team-phantom-community/Phox_Hardware/README.md

# Phoxハードウェア

## 概要
Phoxのハードウェアは完全自作のマイコンボードを中核として様々な小型デバイスを用いている

特にここでは
- 自作ボード回路図
- ハードウェアコンポーネント
- ハードウェア用C++コード

について述べていく

## 必須環境
- Kicad Version 7
- Arduino IDE 2
- ソルダーペースト（ペースト半田）
  - 必須ではないが推奨される
- 半田ごて
- ホットプレート or 温度制限機能付きコンロとフライパン
- 3Dプリンター
- 根気<-最重要
