team-phantom-community/Phox_Hardware/3Ddata/README.md

# 3Dモデルデータ

## 概要
- Phoxの筐体は全て3Dプリントで作成されている
- 上部のLEDについては少し下に向けることで郵便受け全体に明かりを当てられるようにしてある
- カメラの部分についてはスリットを入れることで、過度にカメラを押し付けない仕組みとしてある
- なお、データについてはstlデータのみ載せておく
