team-phantom-community/Phox_Hardware/Phox-code/README.md

# Phox専用C++ code

## 概要
- このコードの役割は
  - 磁気スイッチのオンオフを読む
  - カメラで画像を撮影する
  - バッテリーの電圧を計る
  - Base64変換した画像、測距センサのデータ、バッテリー電圧をJsonデータとしてAWSのAPIGateWayに送る
- 作成したメインボードに[コード](phox_code)を書き込み磁気スイッチに磁石を近づけるとAWS S3に画像が保存される

## AWSのAPI設定
- ここではAWS lambda上で作成したphox image uploaderにAPI Gatewayを関連付ける

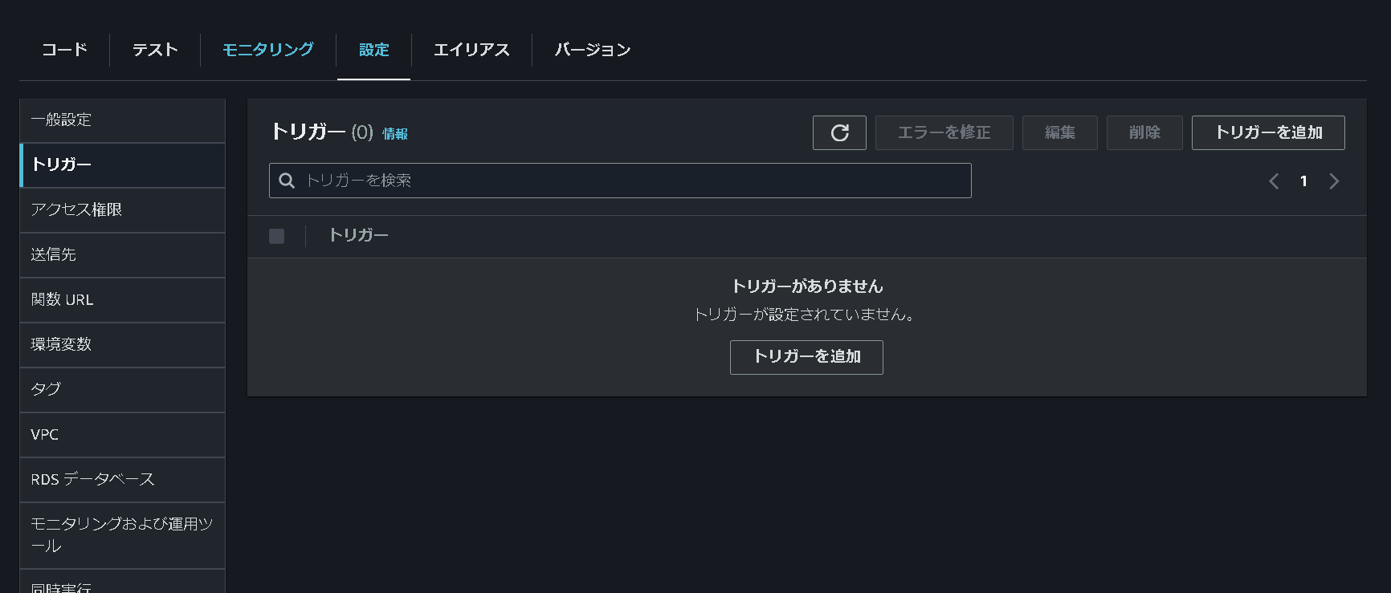
[picture p2: Phox-code/image/set-trigger.PNG]
トリガー設定

- 作成したlambdaの「設定」->「トリガー」に入り、「トリガーを追加」をクリックする

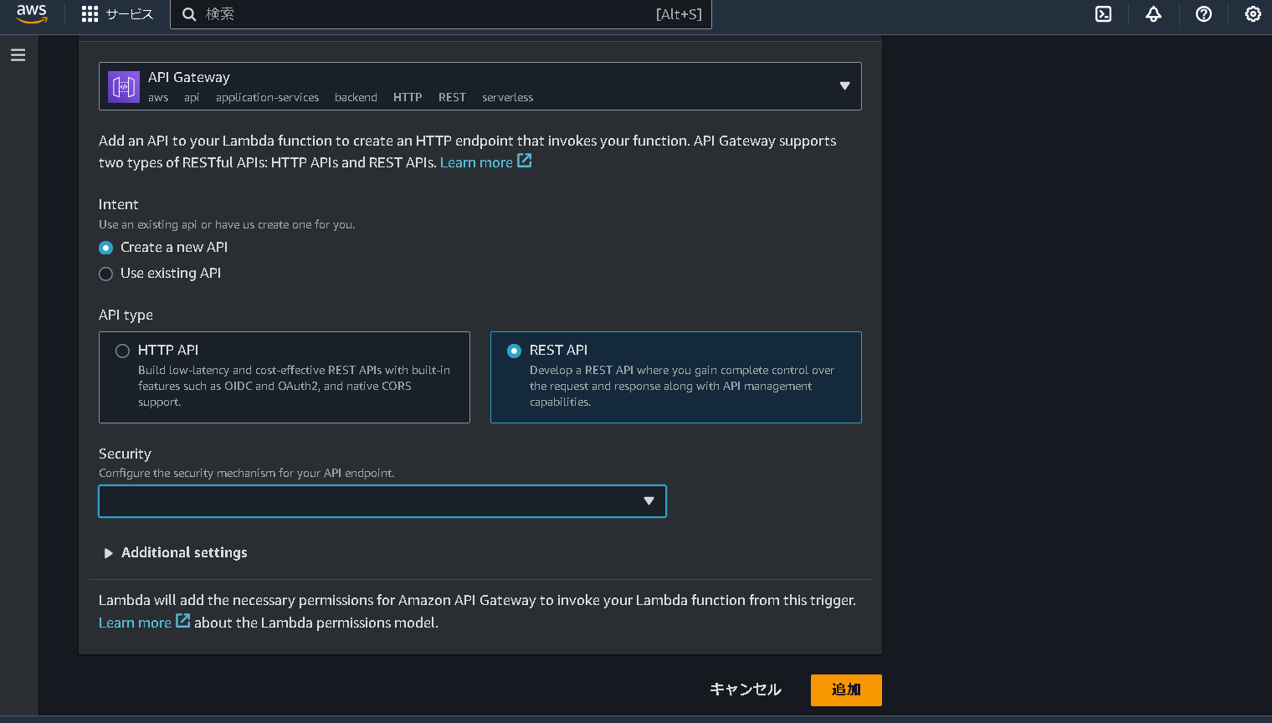
[picture p3: Phox-code/image/trigger-setting.PNG]
トリガーセット

- 次のように設定
  - トリガー：API Gateway
  - Intent：create a new API
  - API type：REST API
  - Security：Open
- これで「追加」
- できたAPI GatewayをクリックしてAPI Gatewayを編集する

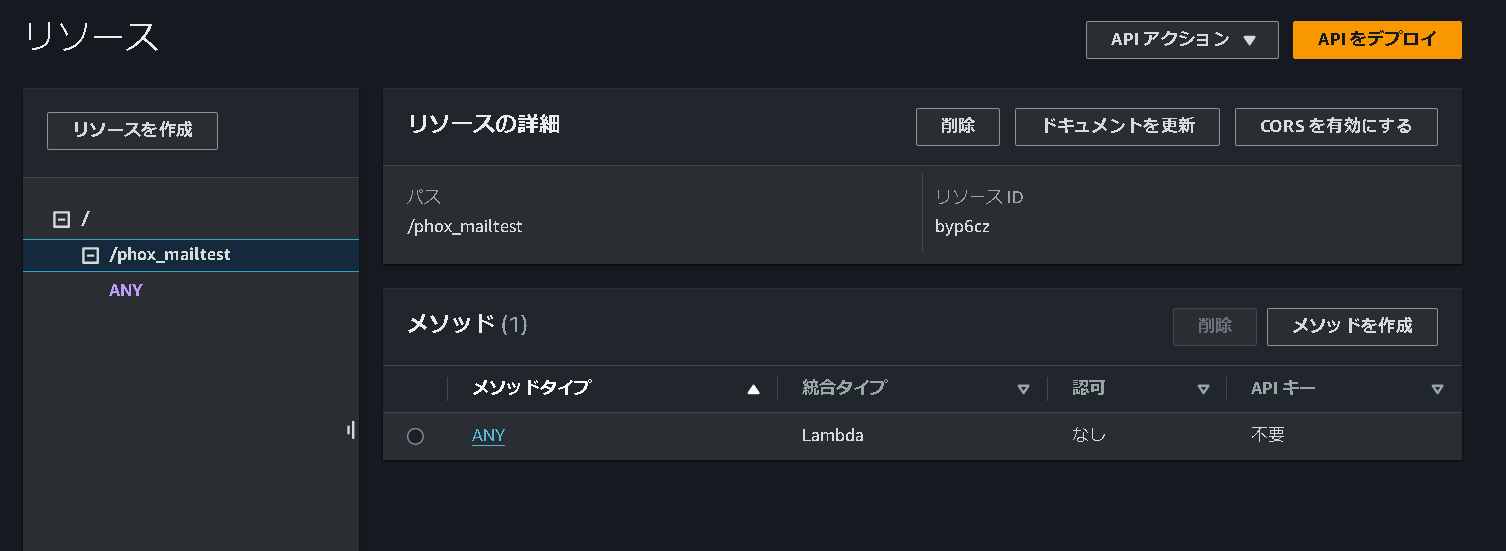
[picture p4: Phox-code/image/method.PNG]
メソッド作成

- 左の「リソース」タブに入り、「メソッドを作成」をクリックする

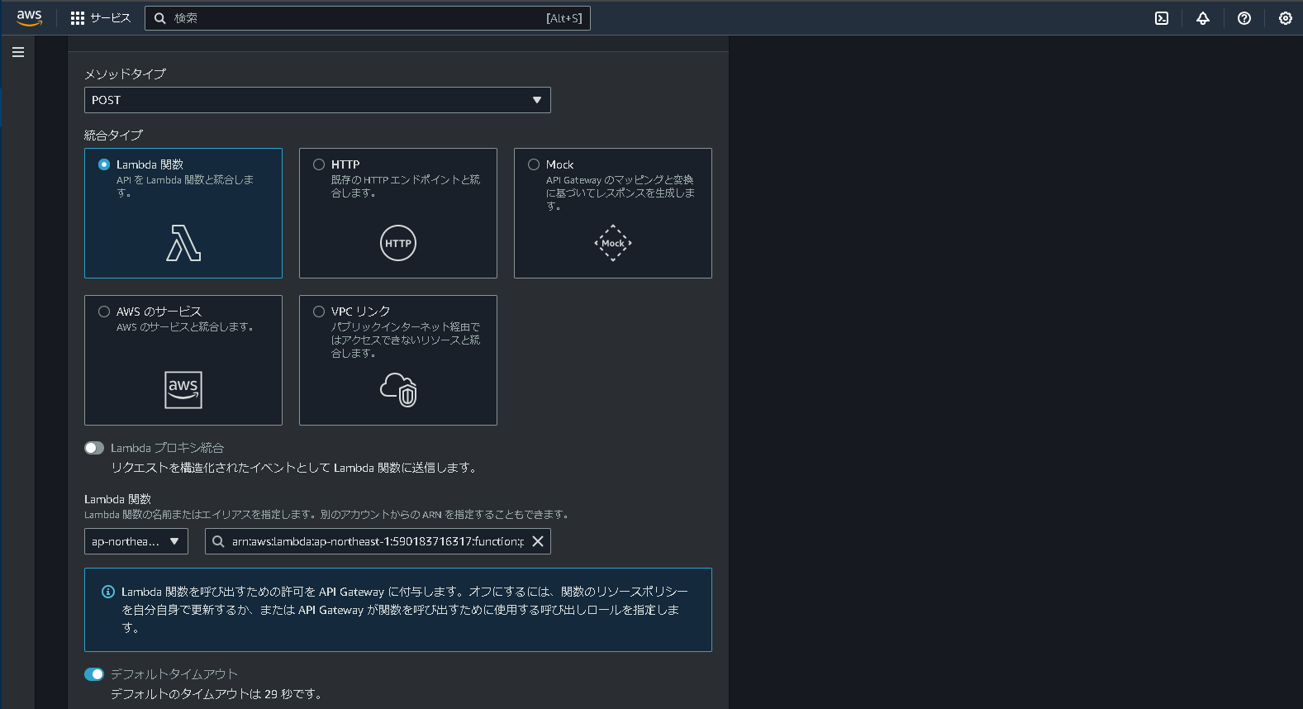
[picture p5: Phox-code/image/method_config.PNG]
メソッド設定

- 次のように設定する
  - メソッドタイプ：POST
  - 統合タイプ：Lambda関数
  - Lambda関数：APIを設定する関数
- これで作成
- POSTメソッドが作成されたらAPIをデプロイする
  - デプロイする際のステージは何でも良い
  - ステージを作成しないのならば「default」
- デプロイすると「ステージの詳細」に「URLを呼び出す」があるのでこのURLを[コード](phox_code)の「AWS_ENDPOINT」にコピペする
