team-phantom-community/Phox_Hardware/3Ddata/stl/Laser-Hall-Unit.stl

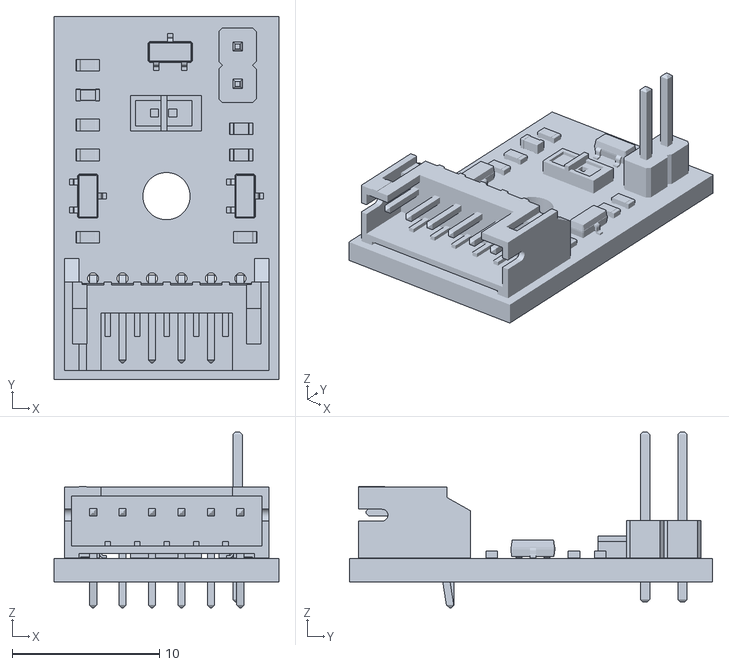
[picture p6: CAD file, 2024-04-12]
3Ddata/stl/Laser-Hall-Unit.stl
15.2 x 24.6 x 11.9
