team-phantom-community/Phox_Hardware/3Ddata/stl/3D_MG_magnet-unit.stl

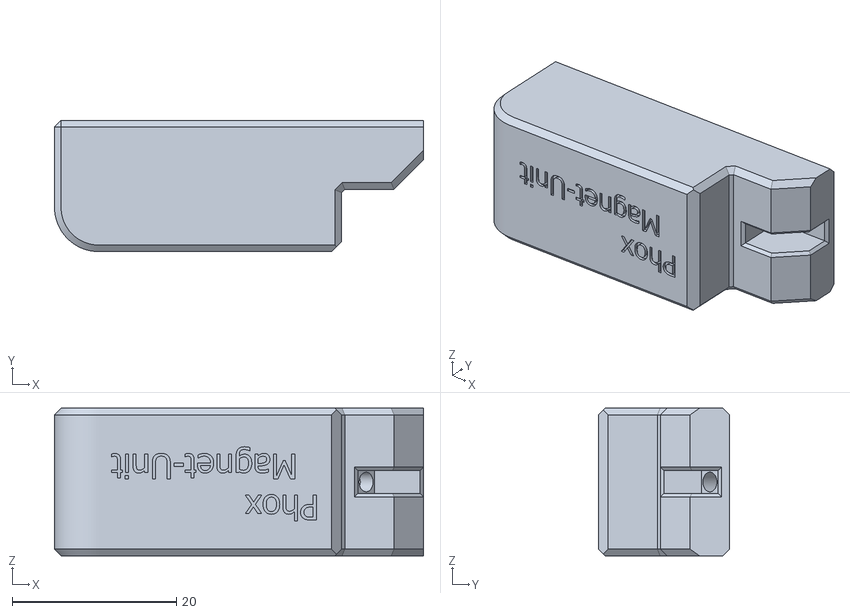
[picture p8: CAD file, 2024-04-12]
3Ddata/stl/3D_MG_magnet-unit.stl
45.0 x 16.0 x 18.0
