team-phantom-community/Phox_Hardware/3Ddata/stl/3D_MA_LED-cover.stl

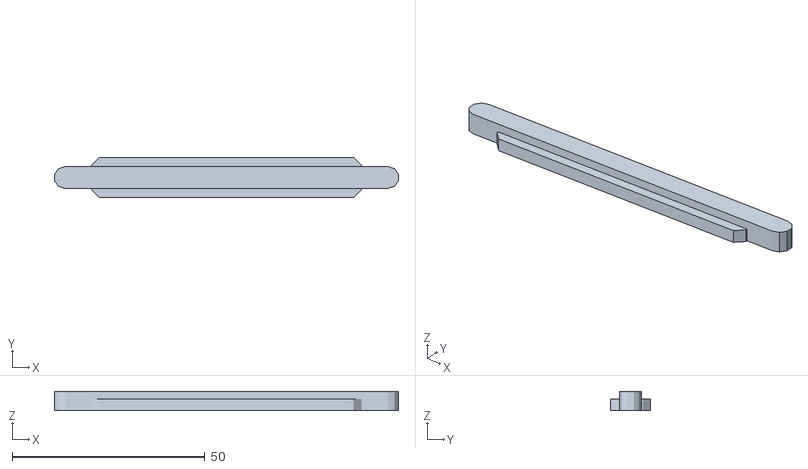
[picture p9: CAD file, 2024-04-12]
3Ddata/stl/3D_MA_LED-cover.stl
89.3 x 10.4 x 5.00
