team-phantom-community/Phox_Hardware/3Ddata/stl/3D_SA_base.stl

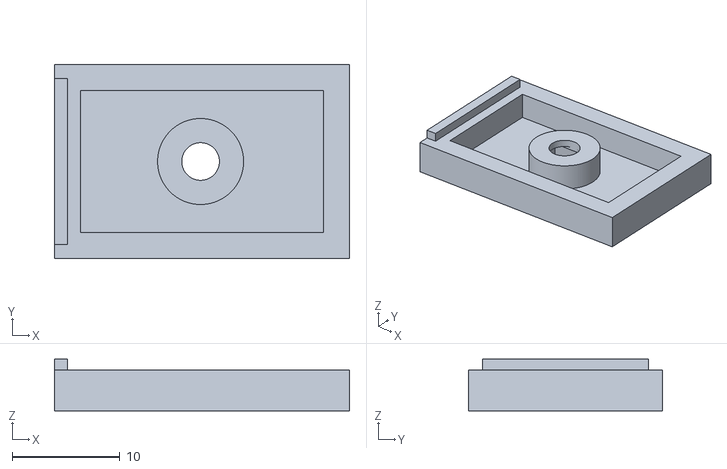
[picture p10: CAD file, 2024-04-12]
3Ddata/stl/3D_SA_base.stl
27.4 x 18.0 x 4.80
