team-phantom-community/Phox_Hardware/3Ddata/stl/3D_MA-base.stl

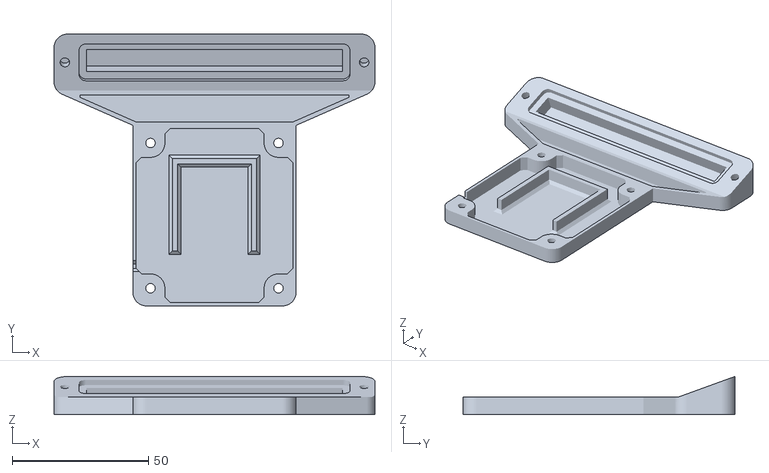
[picture p11: CAD file, 2024-04-12]
3Ddata/stl/3D_MA-base.stl
117.9 x 99.8 x 14.0
