team-phantom-community/Phox_Hardware/3Ddata/stl/3D_MA-cam-top.stl

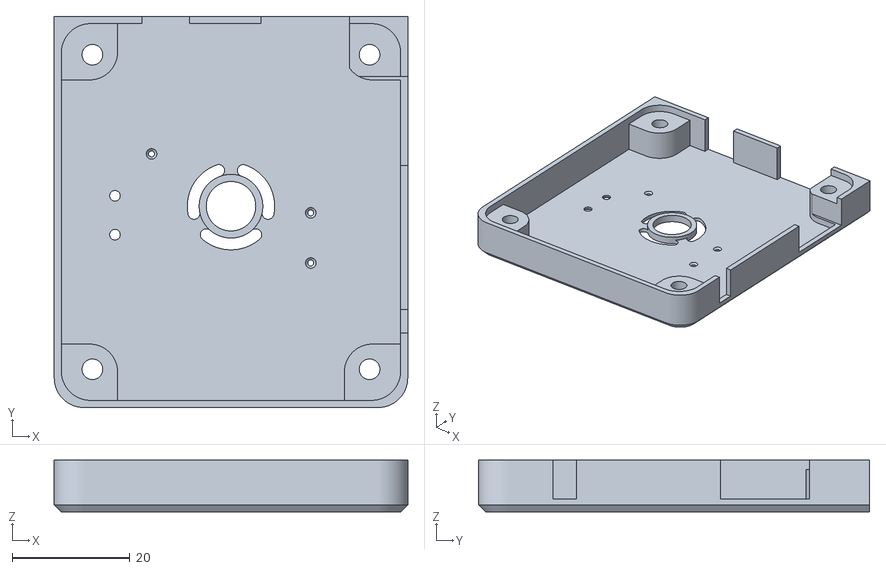
[picture p12: CAD file, 2024-04-12]
3Ddata/stl/3D_MA-cam-top.stl
60.0 x 66.3 x 8.80
