team-phantom-community/Phox_Hardware/3Ddata/stl/3D_MA_LED-top.stl

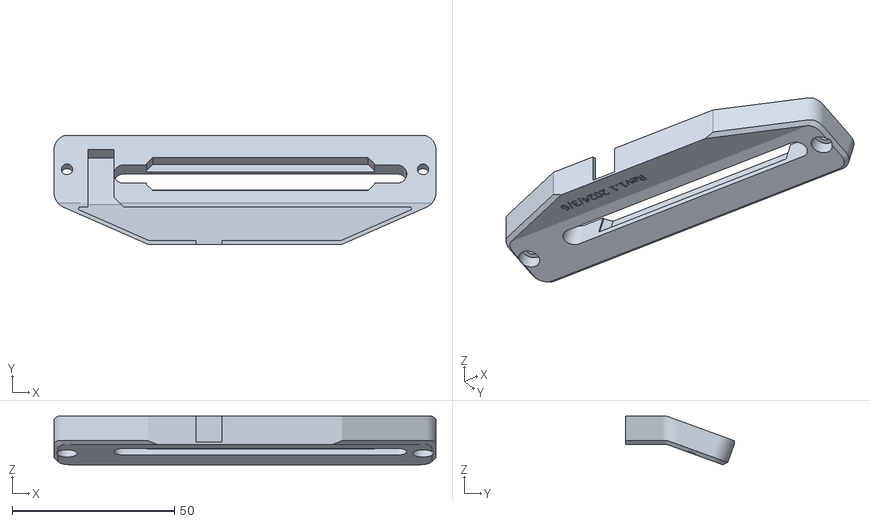
[picture p13: CAD file, 2024-04-12]
3Ddata/stl/3D_MA_LED-top.stl
117.9 x 33.5 x 15.0
