team-phantom-community/Phox_Hardware/KiCad/hall-laser-unit-Rev2.0/Schematics.pdf

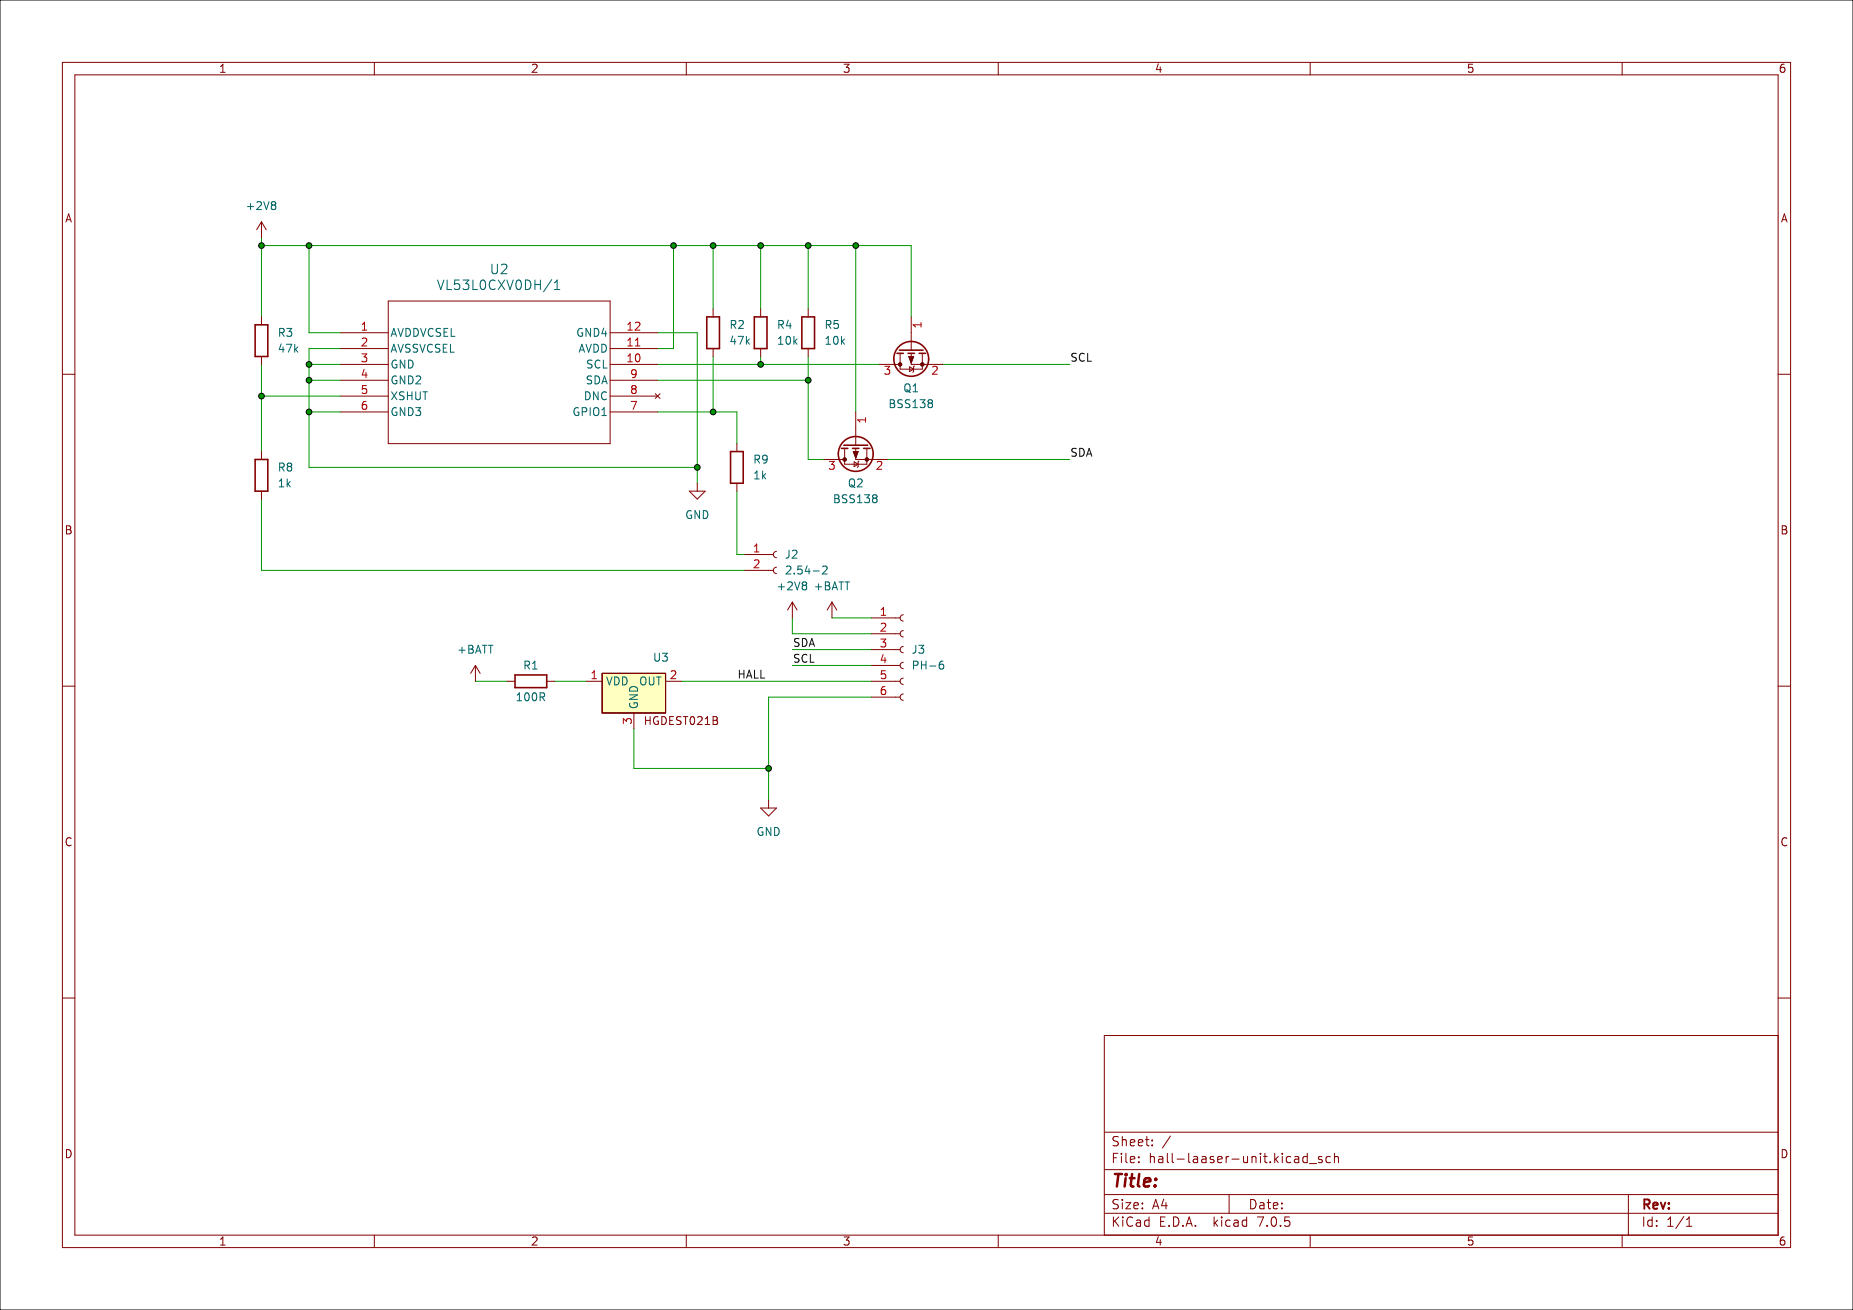
[picture p14: page 1]
