team-phantom-community/Phox_Hardware/KiCad/LED-unit/Schematics.pdf

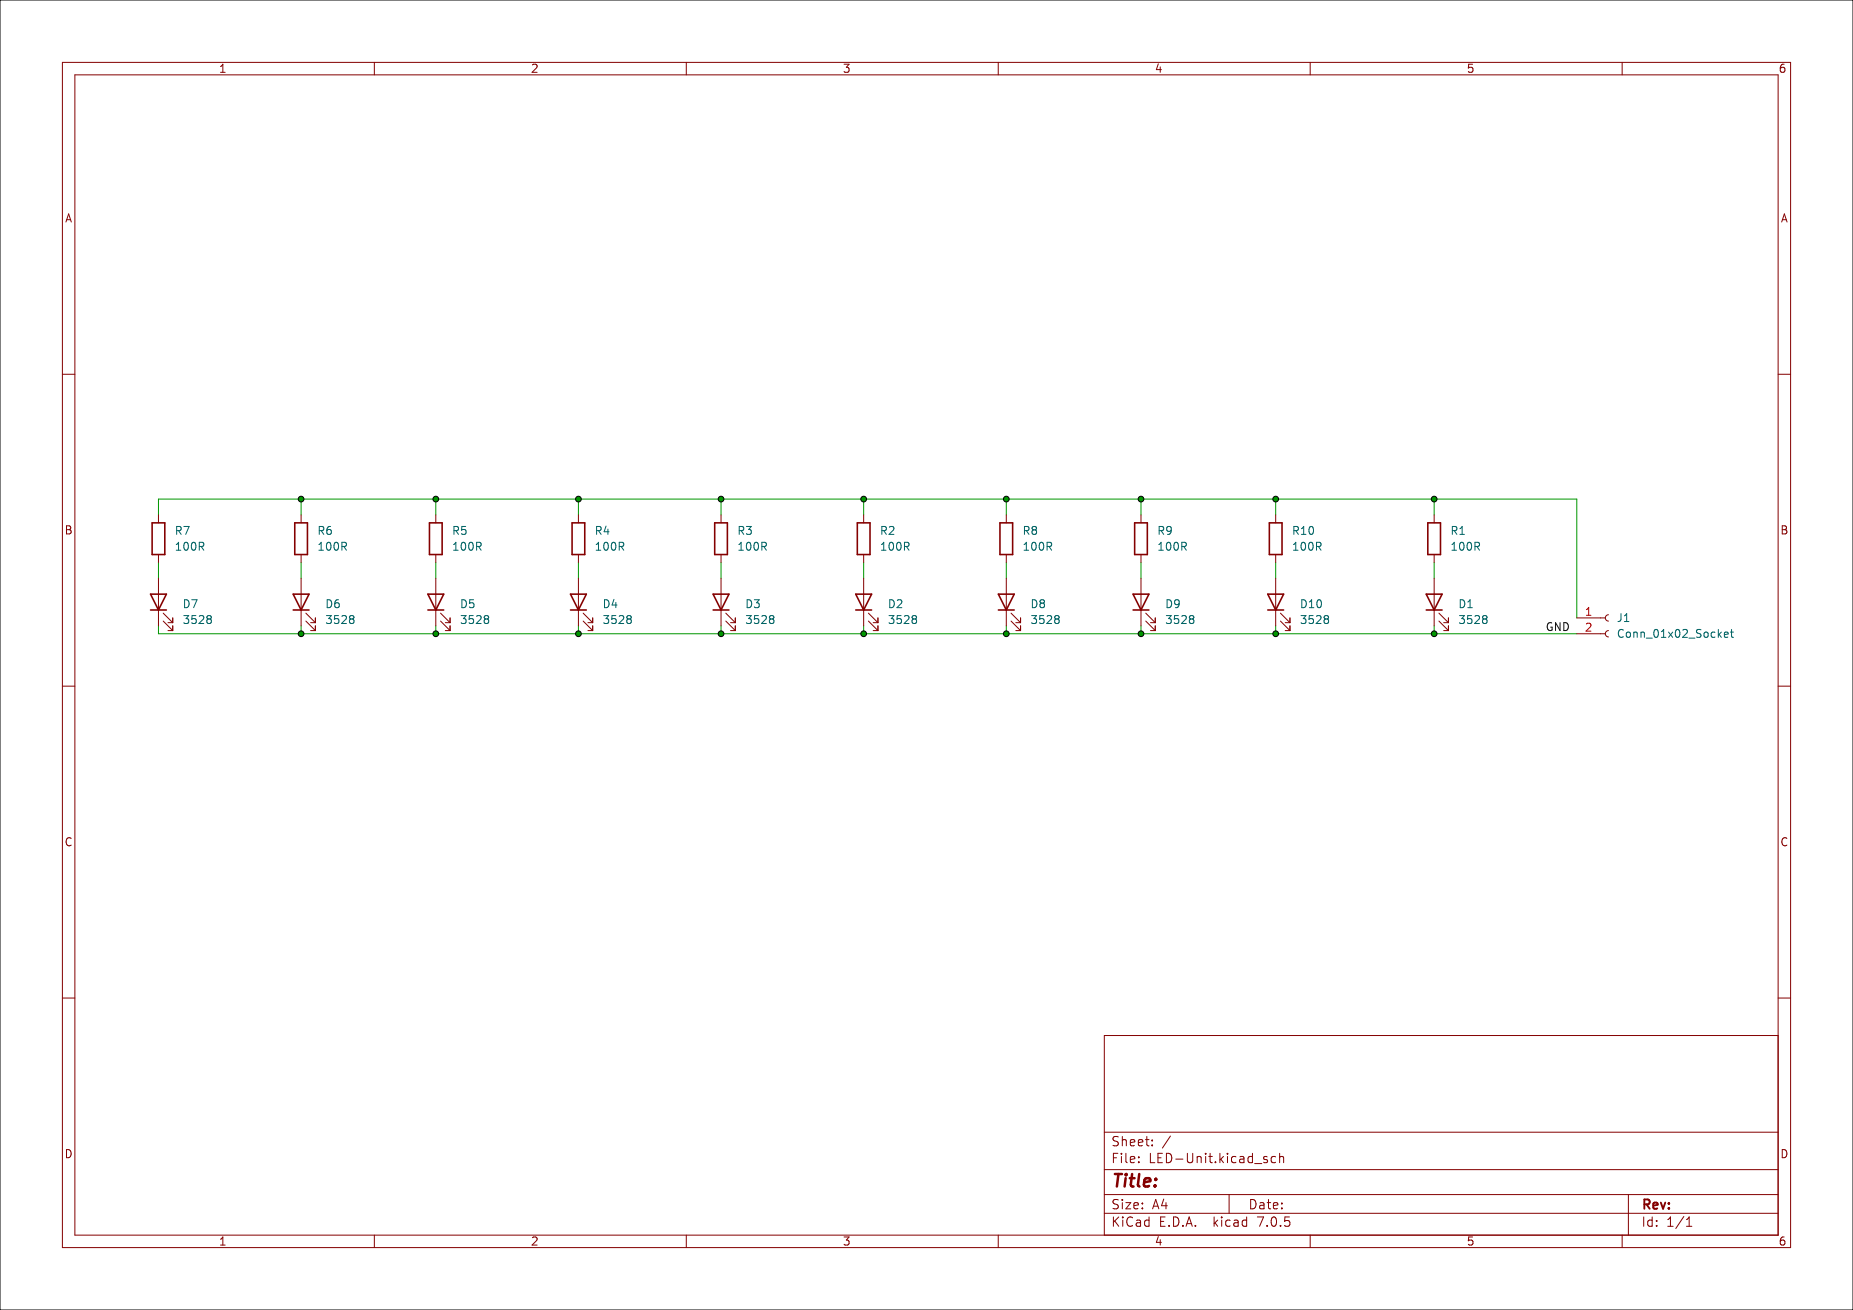
[picture p15: page 1]
