team-phantom-community/Phox_Hardware/KiCad/main-board-Rev1.1/Schematics.pdf

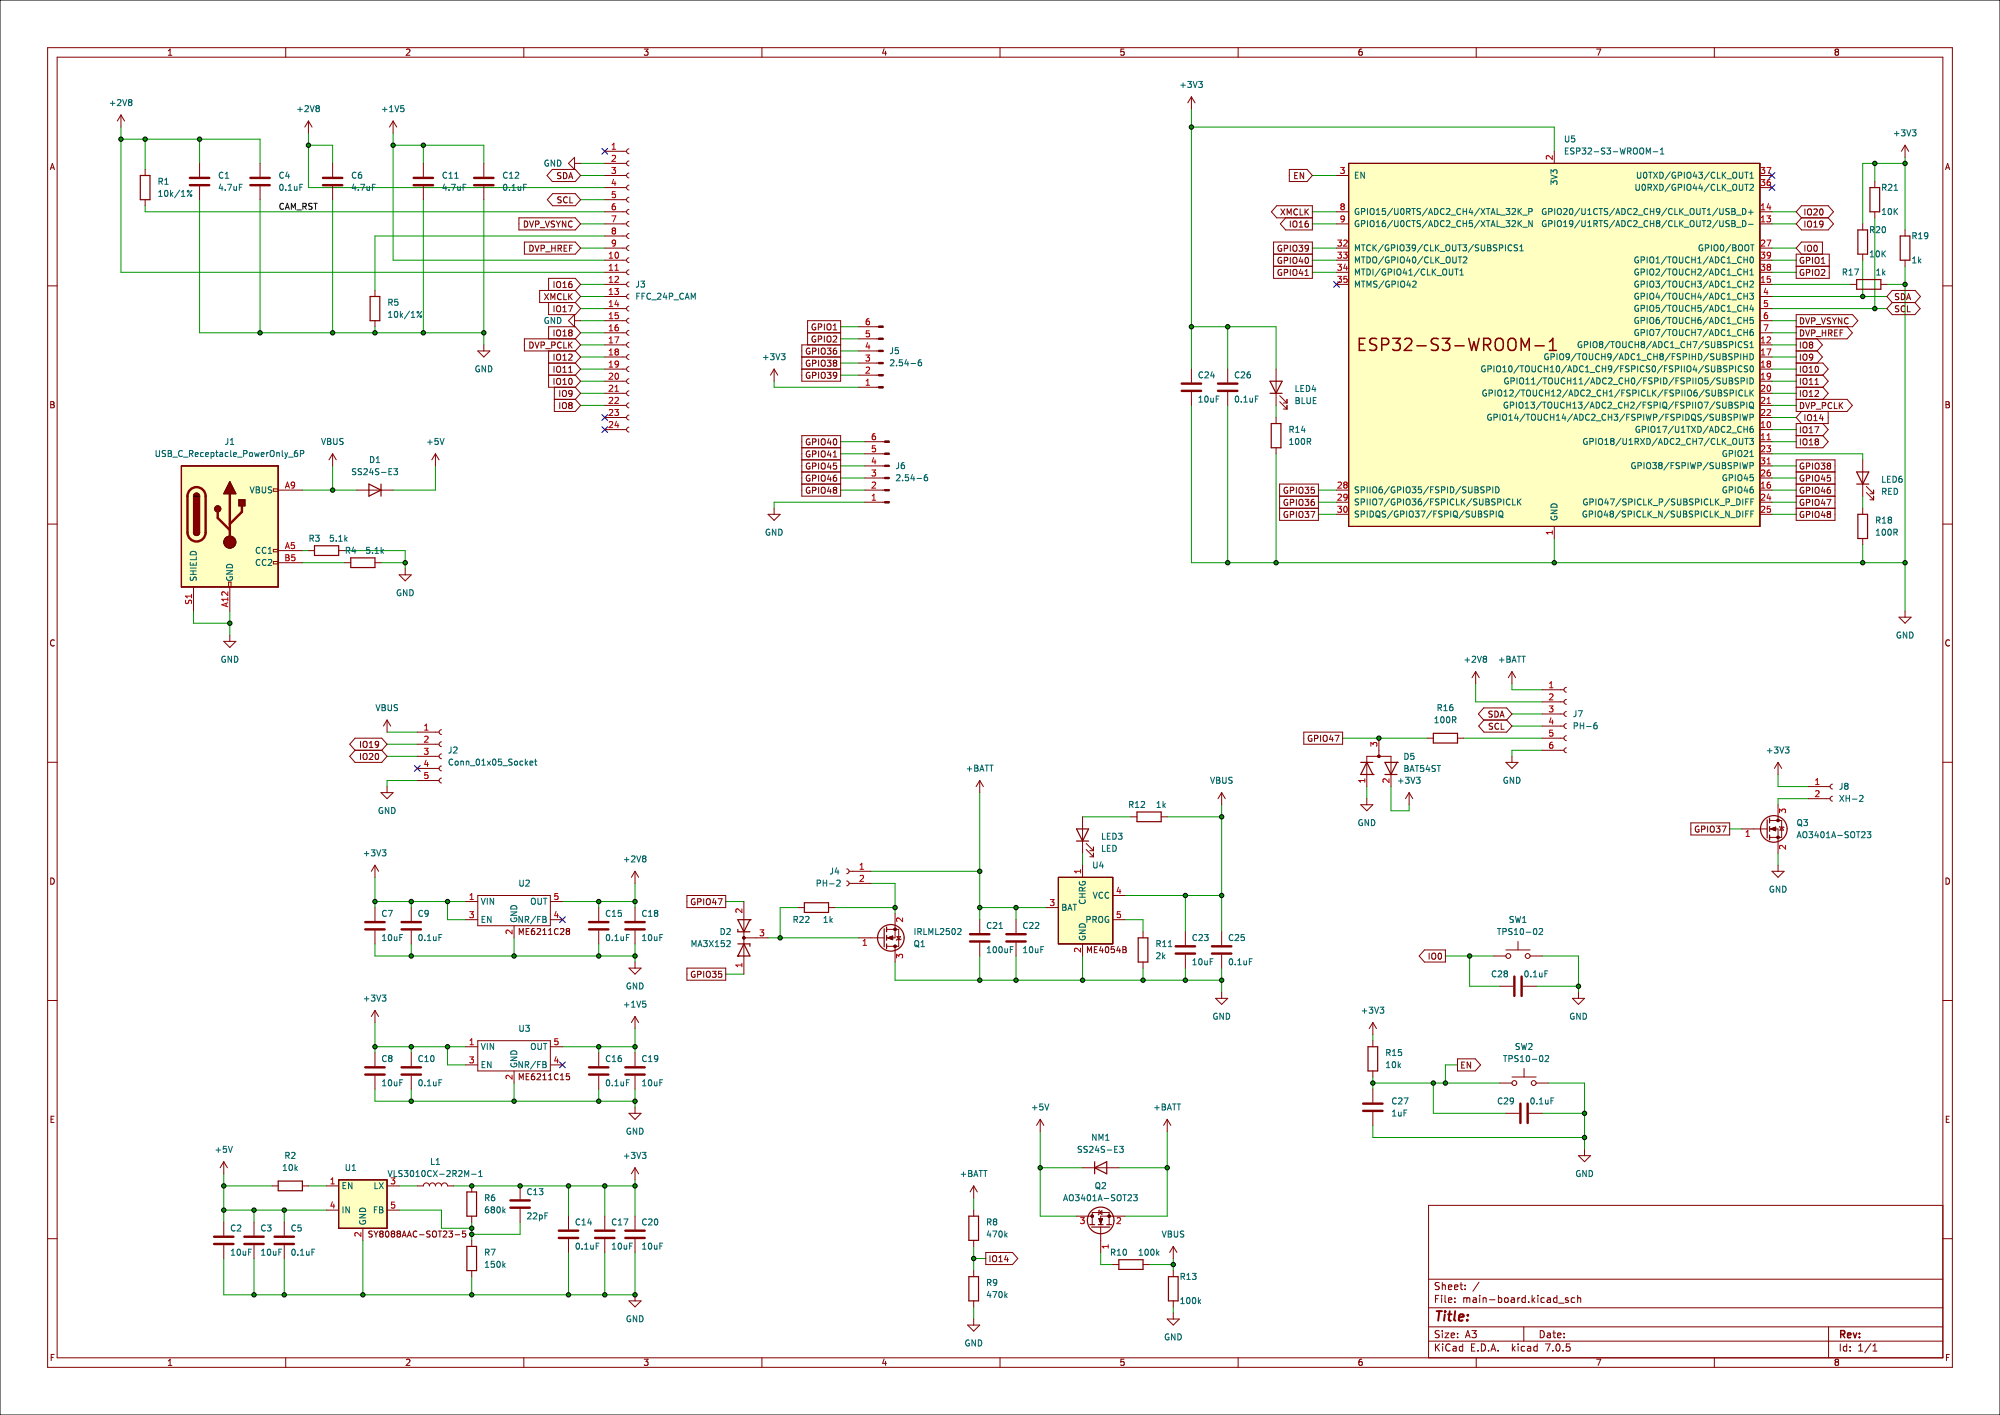
[picture p16: page 1]
