team-phantom-community/Phox_Hardware/KiCad/hall-laser-unit-Rev2.0/Drawing.pdf

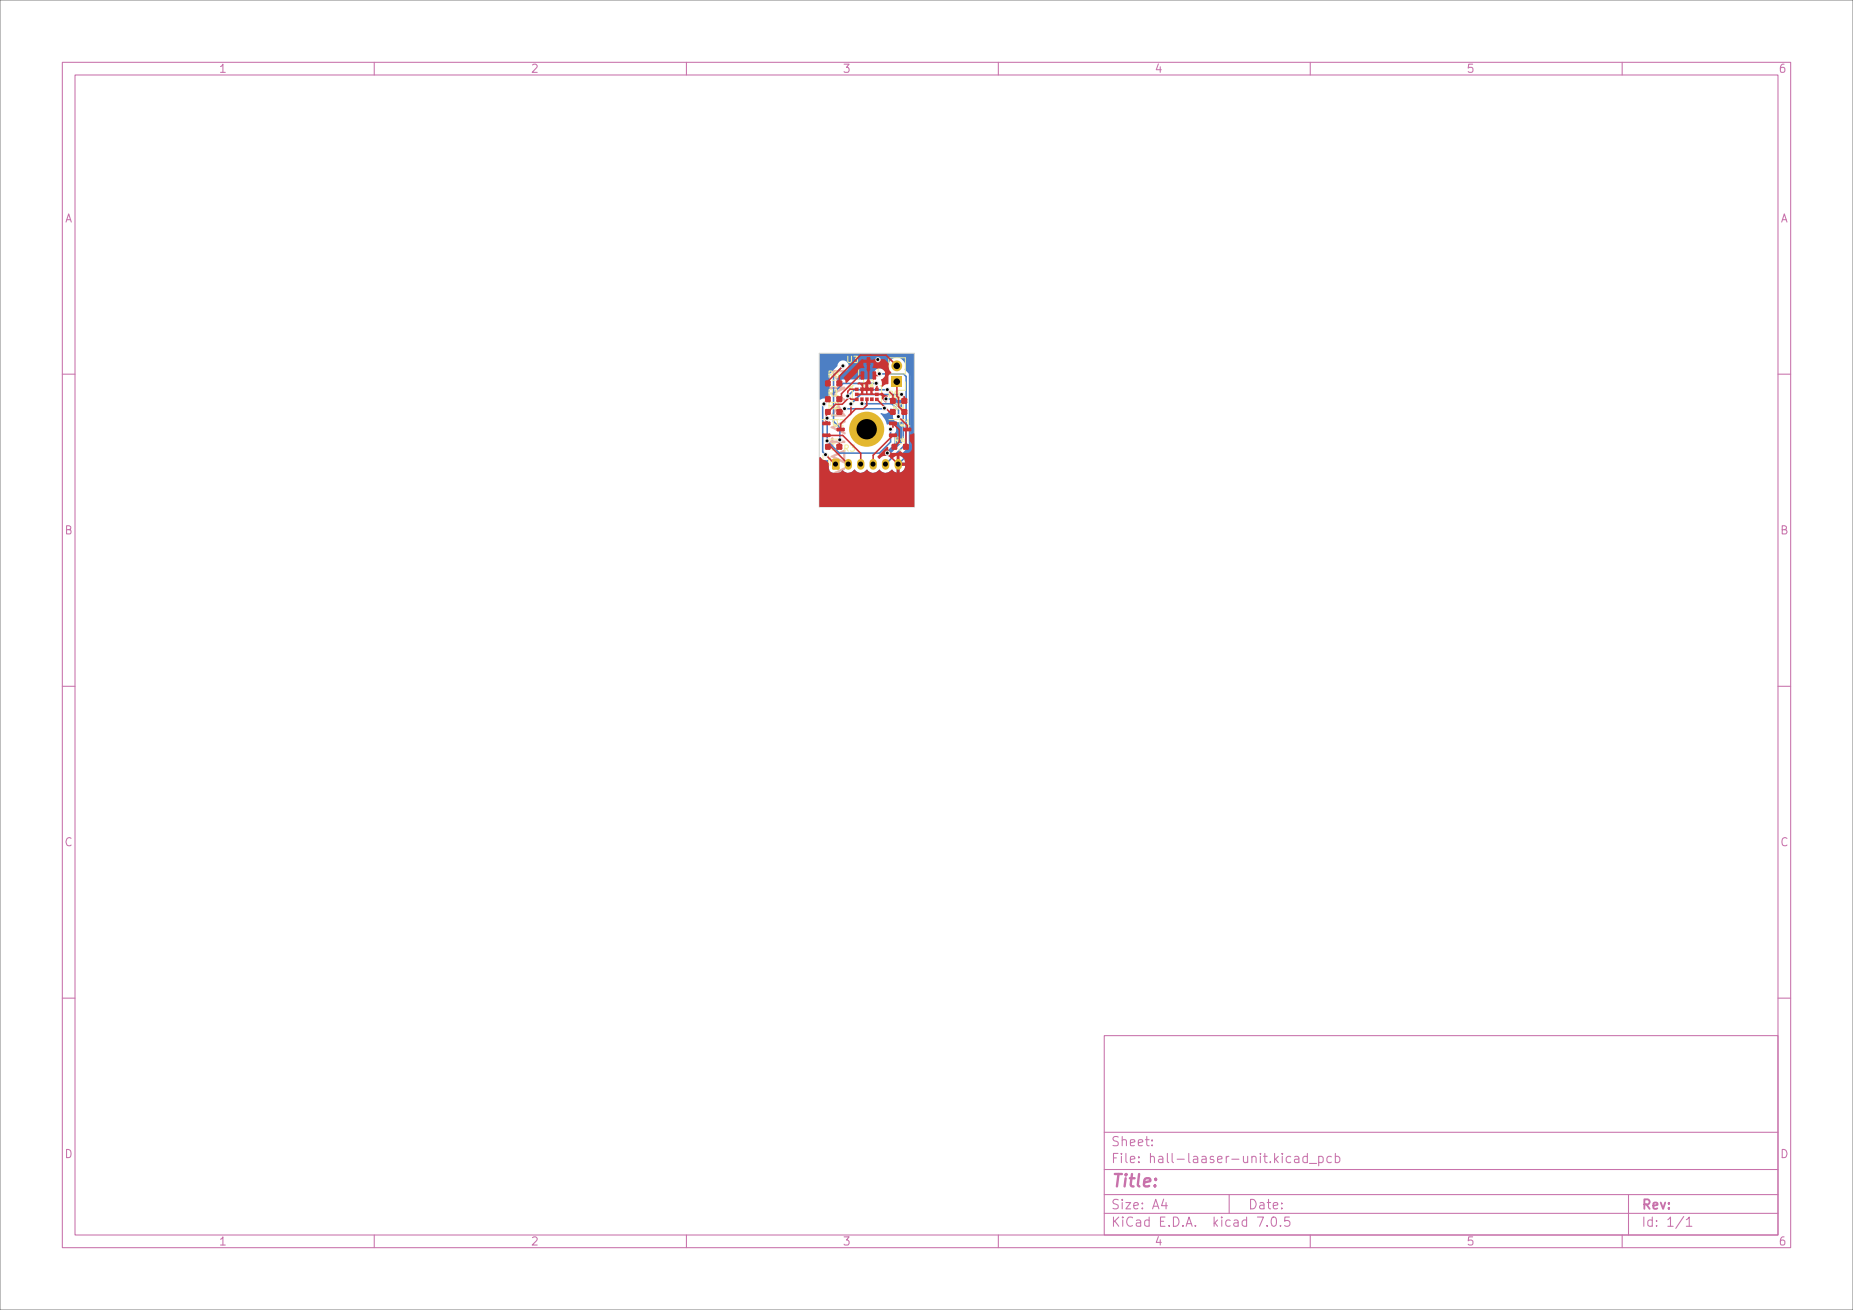
[picture p17: page 1]
