team-phantom-community/Phox_Hardware/KiCad/LED-unit/Drawing.pdf

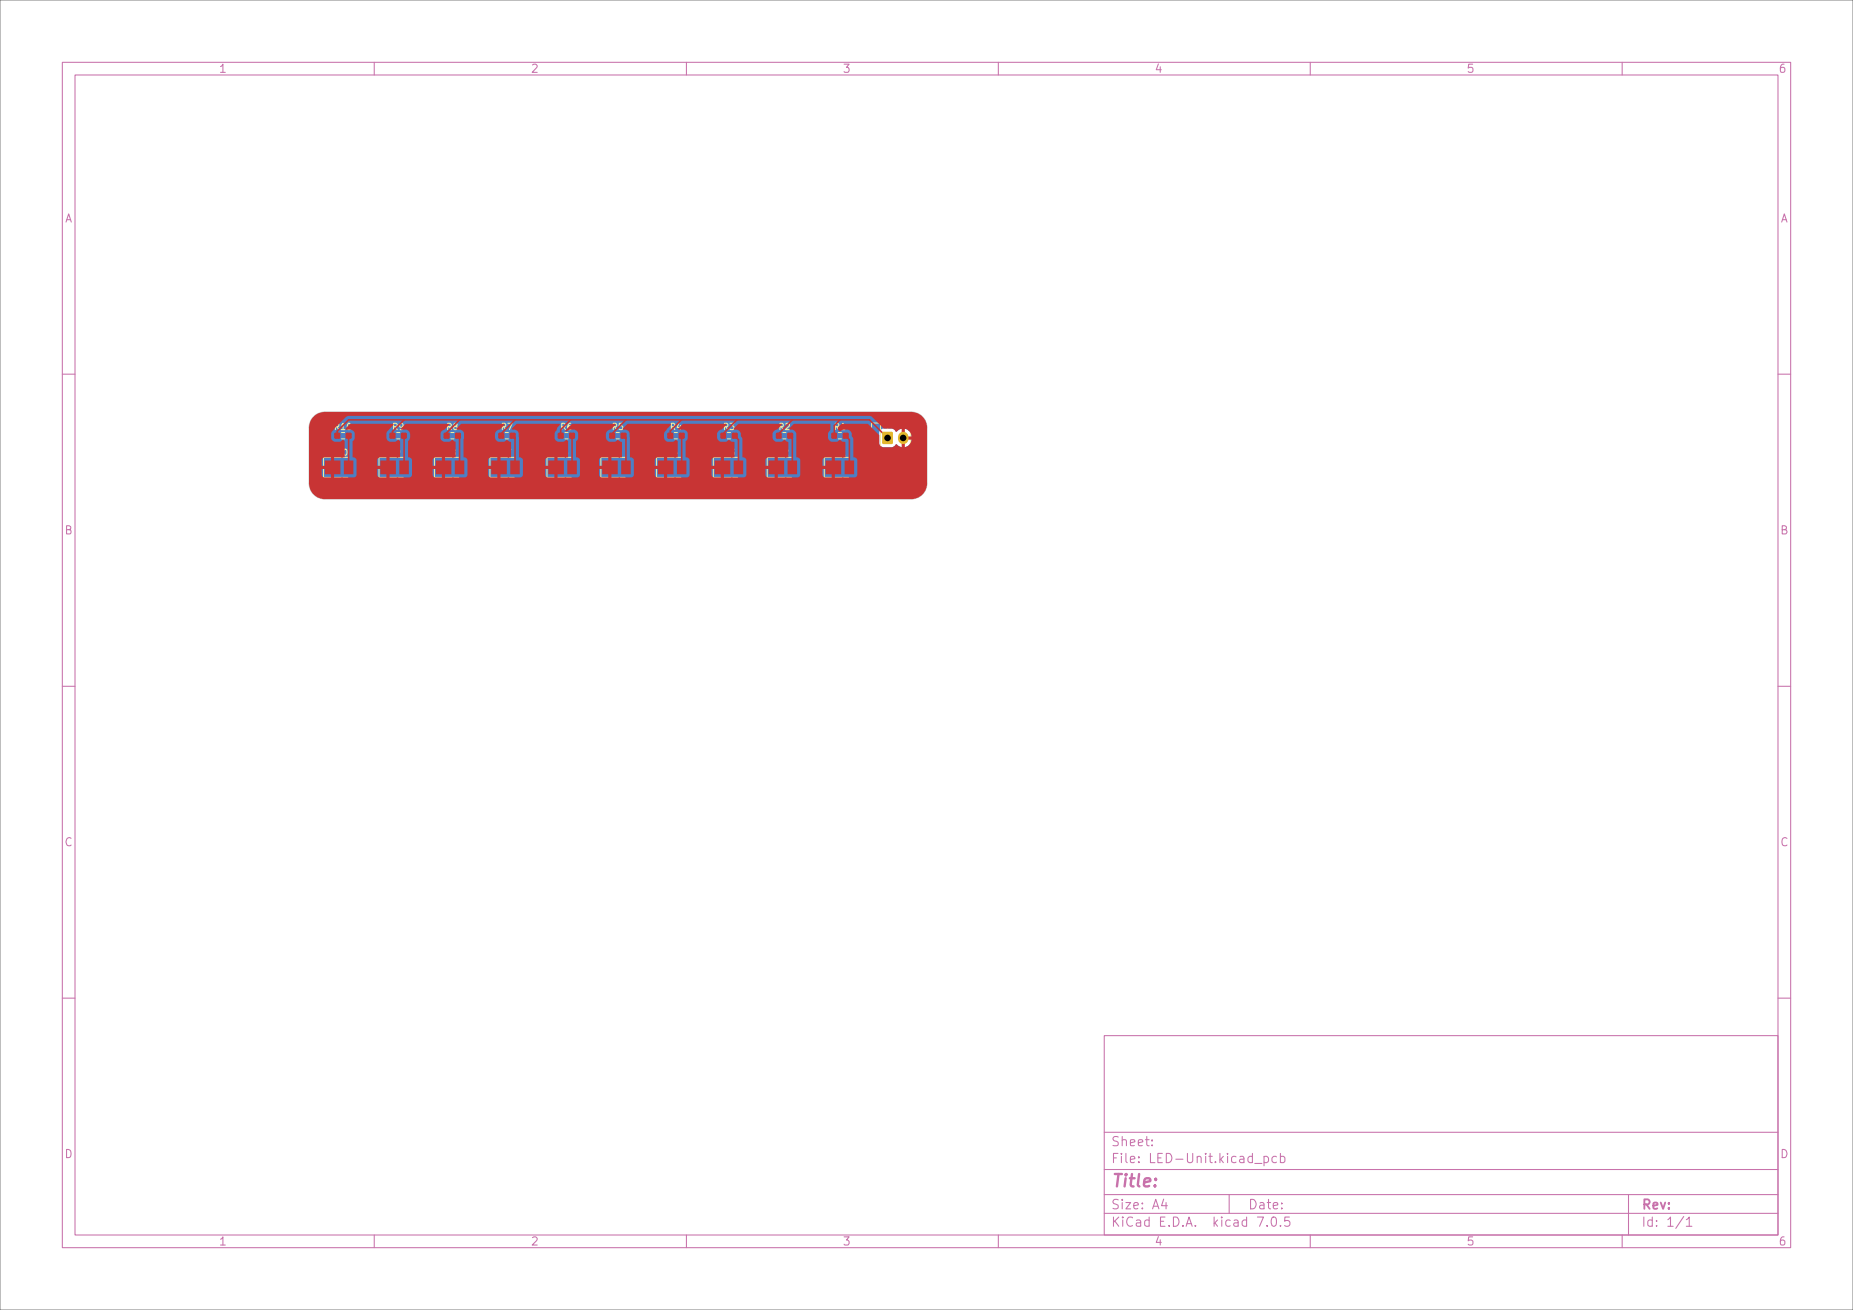
[picture p18: page 1]
