team-phantom-community/Phox_Hardware/KiCad/main-board-Rev1.1/Drawing.pdf

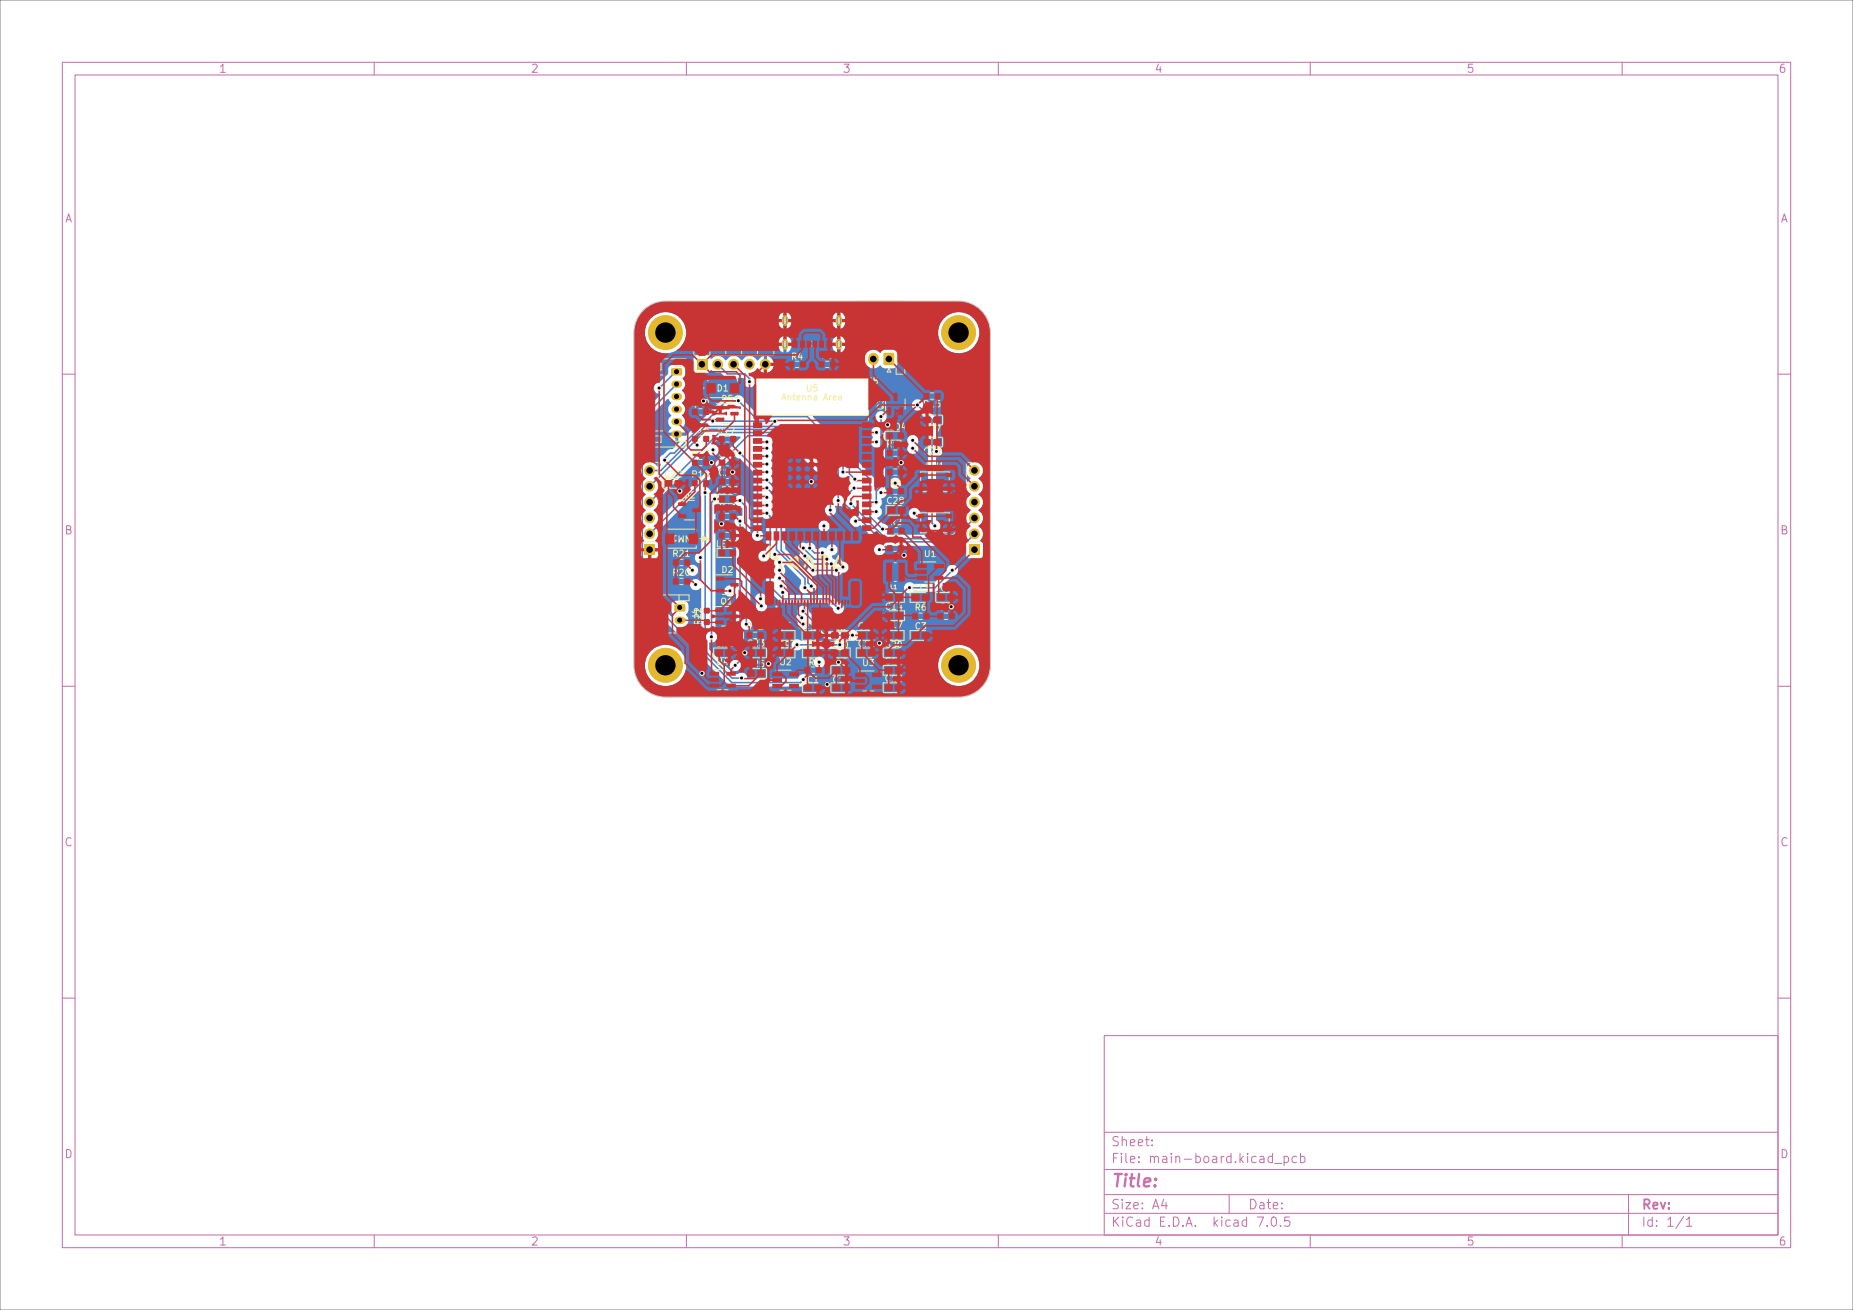
[picture p19: page 1]
