team-phantom-community/Phox_Hardware/KiCad/LED-unit/LED-Unit/LED-Unit.kicad_pcb

## KiCad design KiCad/LED-unit/LED-Unit/LED-Unit.kicad_pcb (2024-04-12)

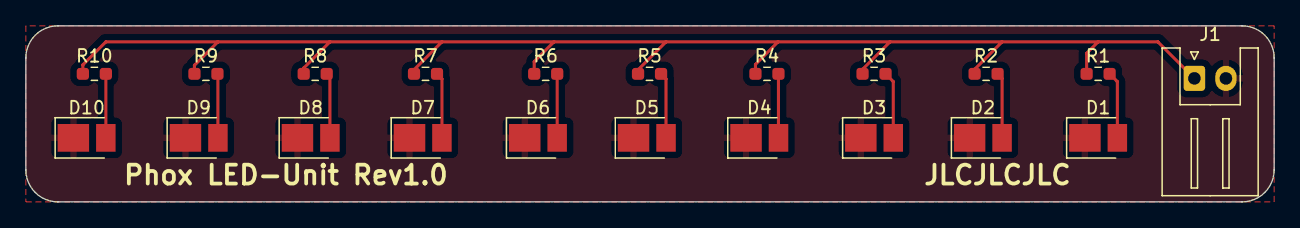
[picture p20: board LED-Unit.kicad_pcb from above]

Board: 2 copper layers, 99.1 x 14.0 mm, 21 parts (0 on the bottom side), 12 nets.

Parts:
D1, D2, D3, D4, D5, D6, D7, D8, D9, D10: TX1812DXA-F01; LED_PLCC_2835_Handsoldering
J1: Conn_01x02_Socket; JST_XH_S2B-XH-A_1x02_P2.50mm_Horizontal
R1, R2, R3, R4, R5, R6, R7, R8, R9, R10: 100R; R_0603_1608Metric_Pad0.98x0.95mm_HandSolder

Connections:
/GND: D1.1 (K), D2.1 (K), D3.1 (K), D4.1 (K), D5.1 (K), D6.1 (K), D7.1 (K), D8.1 (K), D9.1 (K), D10.1 (K), J1.2
unnamed: D1.2 (A), R1.2
unnamed: D2.2 (A), R2.2
unnamed: D3.2 (A), R3.2
unnamed: D4.2 (A), R4.2
unnamed: D5.2 (A), R5.2
unnamed: D6.2 (A), R6.2
unnamed: D7.2 (A), R7.2
unnamed: D8.2 (A), R8.2
unnamed: D9.2 (A), R9.2
unnamed: D10.2 (A), R10.2
unnamed: J1.1, R1.1, R2.1, R3.1, R4.1, R5.1, R6.1, R7.1, R8.1, R9.1, R10.1
