team-phantom-community/Phox_Hardware/KiCad/main-board-Rev1.1/main-board/main-board.kicad_pcb

## KiCad design KiCad/main-board-Rev1.1/main-board/main-board.kicad_pcb (2024-04-12)

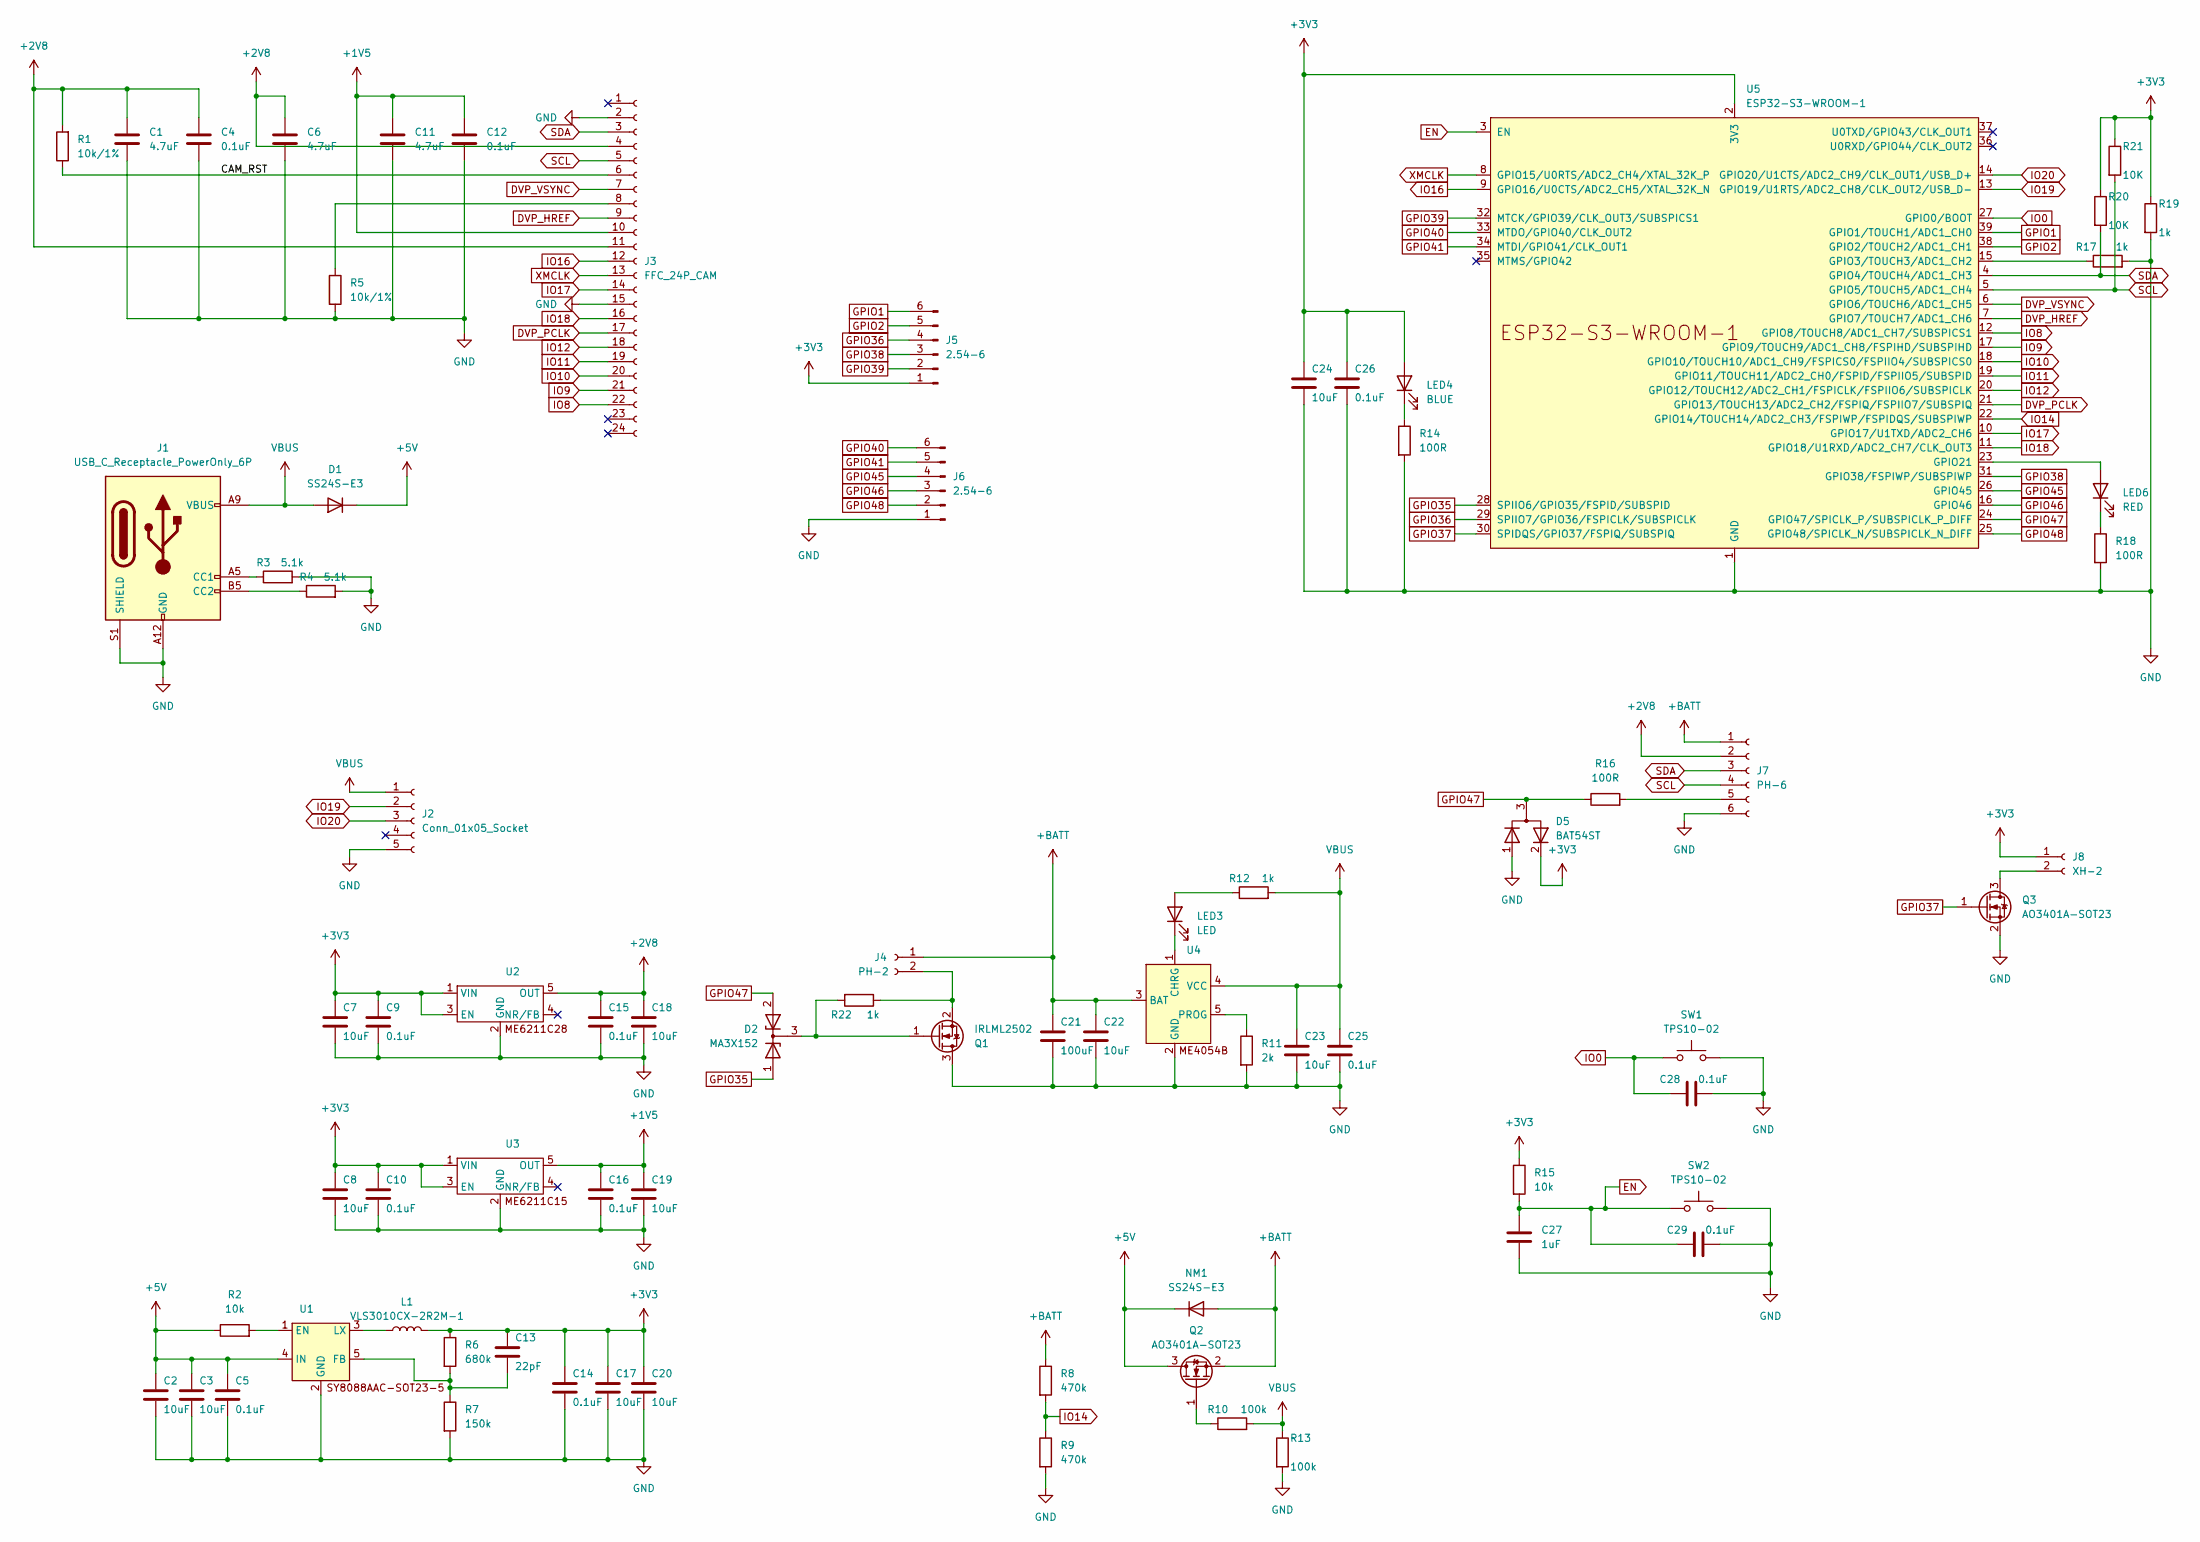
[picture p21: schematic main-board.kicad_sch]

Parts:
C1, C6, C11: 4.7uF; CP_EIA-1608-08_AVX-J_Pad1.25x1.05mm_HandSolder
C2, C3, C7, C8, C17, C18, C19, C20, C22, C23: 10uF; CP_EIA-1608-08_AVX-J_Pad1.25x1.05mm_HandSolder
C4, C5, C9, C10, C12, C14, C15, C16, C25, C28, C29: 0.1uF; CP_EIA-1608-08_AVX-J_Pad1.25x1.05mm_HandSolder
C13: 22pF; CP_EIA-1608-08_AVX-J_Pad1.25x1.05mm_HandSolder
C21: 100uF; CP_EIA-1608-08_AVX-J_Pad1.25x1.05mm_HandSolder
C24: 10uF; C_0603_1608Metric_Pad1.08x0.95mm_HandSolder
C26: 0.1uF; C_0603_1608Metric_Pad1.08x0.95mm_HandSolder
C27: 1uF; CP_EIA-1608-08_AVX-J_Pad1.25x1.05mm_HandSolder
D1: SS24S-E3; CR_S-E3&slash_61T_VIS
D2: MA3X152; SOT-23-3
D5: BAT54ST; SOT-23-3
J1: USB_C_Receptacle_PowerOnly_6P; CONN6_UJC-HP-3-SMT-TR_CUD
J2: Conn_01x05_Socket; PinHeader_1x05_P2.54mm_Horizontal
J3: FFC_24P_CAM; FFC24P_cam
J4: PH-2; JST_PH_S2B-PH-K_1x02_P2.00mm_Horizontal
J5, J6: 2.54-6; PinHeader_1x06_P2.54mm_Vertical
J7: PH-6; JST_PH_S6B-PH-K_1x06_P2.00mm_Horizontal
J8: XH-2; JST_XH_S2B-XH-A_1x02_P2.50mm_Horizontal
L1: VLS3010CX-2R2M-1; IND_VLS3010CX-2R2M-1
LED3: LED; LED_0603_1608Metric_Pad1.05x0.95mm_HandSolder
LED4: BLUE; LED_0603_1608Metric_Pad1.05x0.95mm_HandSolder
LED6: RED; LED_0603_1608Metric_Pad1.05x0.95mm_HandSolder
NM1: SS24S-E3; CR_S-E3&slash_61T_VIS
Q1: IRLML2502; SOT-23-3
Q2, Q3: AO3401A-SOT23; SOT-23-3
R1, R5: 10k/1%; R_0603_1608Metric_Pad0.98x0.95mm_HandSolder
R2, R15: 10k; R_0603_1608Metric_Pad0.98x0.95mm_HandSolder
R3, R4: 5.1k; R_0603_1608Metric_Pad0.98x0.95mm_HandSolder
R6: 680k; R_0603_1608Metric_Pad0.98x0.95mm_HandSolder
R7: 150k; R_0603_1608Metric_Pad0.98x0.95mm_HandSolder
R8, R9: 470k; R_0603_1608Metric_Pad0.98x0.95mm_HandSolder
R10, R13: 100k; R_0603_1608Metric_Pad0.98x0.95mm_HandSolder
R11: 2k; R_0603_1608Metric_Pad0.98x0.95mm_HandSolder
R12, R17, R19, R22: 1k; R_0603_1608Metric_Pad0.98x0.95mm_HandSolder
R14, R16, R18: 100R; R_0603_1608Metric_Pad0.98x0.95mm_HandSolder
R20, R21: 10K; R_0603_1608Metric_Pad0.98x0.95mm_HandSolder
SW1, SW2: TPS10-02; SW_pts815
U1, U2, U3, U4: SOT-23-5_HandSoldering
U5: ESP32-S3-WROOM-1

Connections:
+1V5: C11.1, C12.1, C16.1, C19.1, J3.10, U3.5 (OUT)
+2V8: C1.1, C4.1, C6.1, C15.1, C18.1, J3.4, J3.11, J7.2, R1.2, U2.5 (OUT)
+3V3: C7.1, C8.1, C9.1, C10.1, C13.1, C14.1, C17.1, C20.1, C24.1, C26.1, D5.2 (K), J5.1, J8.1, L1.2, LED4.2 (A), R6.1, R15.1, R19.1, R20.1, R21.1, U2.1 (VIN), U2.3 (EN), U3.1 (VIN), U3.3 (EN), U5.2 (3V3)
+5V: C2.1, C3.1, C5.1, D1.1 (K), NM1.1 (K), Q2.3 (D), R2.1, U1.4 (IN)
+BATT: C21.1, C22.1, J4.1, J7.1, NM1.2 (A), Q2.2 (S), R8.1, U4.3 (BAT)
/CAM_RST: J3.6, R1.1
DVP_HREF: J3.9, U5.7 (GPIO7/TOUCH7/ADC1_CH6)
DVP_PCLK: J3.17, U5.21 (GPIO13/TOUCH13/ADC2_CH2/FSPIQ/FSPIIO7/S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)
DVP_VSYNC: J3.7, U5.6 (GPIO6/TOUCH6/ADC1_CH5)
EN: C27.1, C29.1, R15.2, SW2.1, U5.3 (EN)
GND: C1.2, C2.2, C3.2, C4.2, C5.2, C6.2, C7.2, C8.2, C9.2, C10.2, C11.2, C12.2, C14.2, C15.2, C16.2, C17.2, C18.2, C19.2, C20.2, C21.2, C22.2, C23.2, C24.2, C25.2, C26.2, C27.2, C28.2, C29.2, D5.1 (K), J1.A12 (GND), J1.B12 (GND), J1.S1 (SHIELD), J2.5, J3.2, J3.15, J6.1, J7.6, Q1.3 (D), Q3.2 (S), R3.2, R4.2, R5.2, R7.2, R9.2, R11.2, R13.2, R14.2, R17.2, R18.2, R19.2, SW1.2, SW2.2, U1.2 (GND), U2.2 (GND), U3.2 (GND), U4.2 (GND), U5.1 (GND), U5.40 (GND), U5.41 (GND)
GPIO1: J5.6, U5.39 (GPIO1/TOUCH1/ADC1_CH0)
GPIO2: J5.5, U5.38 (GPIO2/TOUCH2/ADC1_CH1)
GPIO35: D2.1 (A), U5.28 (SPIIO6/GPIO35/FSPID/SUBSPID)
GPIO36: J5.4, U5.29 (SPIIO7/GPIO36/FSPICLK/SUBSPICLK)
GPIO37: Q3.1 (G), U5.30 (SPIDQS/GPIO37/FSPIQ/SUBSPIQ)
GPIO38: J5.3, U5.31 (GPIO38/FSPIWP/SUBSPIWP)
GPIO39: J5.2, U5.32 (MTCK/GPIO39/CLK_OUT3/SUBSPICS1)
GPIO40: J6.6, U5.33 (MTDO/GPIO40/CLK_OUT2)
GPIO41: J6.5, U5.34 (MTDI/GPIO41/CLK_OUT1)
GPIO45: J6.4, U5.26 (GPIO45)
GPIO46: J6.3, U5.16 (GPIO46)
GPIO47: D2.2 (A), D5.3 (A), R16.1, U5.24 (GPIO47/SPICLK_P/SUBSPICLK_P_DIFF)
GPIO48: J6.2, U5.25 (GPIO48/SPICLK_N/SUBSPICLK_N_DIFF)
IO0: C28.1, SW1.1, U5.27 (GPIO0/BOOT)
IO8: J3.22, U5.12 (GPIO8/TOUCH8/ADC1_CH7/SUBSPICS1)
IO9: J3.21, U5.17 (GPIO9/TOUCH9/ADC1_CH8/FSPIHD/SUBSPIHD)
IO10: J3.20, U5.18 (GPIO10/TOUCH10/ADC1_CH9/FSPICS0/FSPIIO4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)
IO11: J3.19, U5.19 (GPIO11/TOUCH11/ADC2_CH0/FSPID/FSPIIO5/S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)
IO12: J3.18, U5.20 (GPIO12/TOUCH12/ADC2_CH1/FSPICLK/FSPIIO6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)
IO14: R8.2, R9.1, U5.22 (GPIO14/TOUCH14/ADC2_CH3/FSPIWP/FSPIDQS/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)
IO16: J3.12, U5.9 (GPIO16/U0CTS/ADC2_CH5/XTAL_32K_N)
IO17: J3.14, U5.10 (GPIO17/U1TXD/ADC2_CH6)
IO18: J3.16, U5.11 (GPIO18/U1RXD/ADC2_CH7/CLK_OUT3)
IO19: J2.2, U5.13 (GPIO19/U1RTS/ADC2_CH8/CLK_OUT2/USB_D-)
IO20: J2.3, U5.14 (GPIO20/U1CTS/ADC2_CH9/CLK_OUT1/USB_D+)
unnamed: D2.3 (K), Q1.1 (G), R22.2
unnamed: J1.A5 (CC1), R3.1
unnamed: J1.B5 (CC2), R4.1
unnamed: J3.8, R5.1
unnamed: J4.2, Q1.2 (S), R22.1
unnamed: J7.5, R16.2
unnamed: J8.2, Q3.3 (D)
unnamed: LED3.2 (A), R12.1
unnamed: LED3.1 (K), U4.1 (CHRG)
unnamed: LED4.1 (K), R14.1
unnamed: LED6.2 (A), U5.23 (GPIO21)
unnamed: LED6.1 (K), R18.1
unnamed: Q2.1 (G), R10.1
unnamed: R2.2, U1.1 (EN)
unnamed: C13.2, R6.2, R7.1, U1.5 (FB)
unnamed: L1.1, U1.3 (LX)
unnamed: R11.1, U4.5 (PROG)
unnamed: R17.1, U5.15 (GPIO3/TOUCH3/ADC1_CH2)
SCL: J3.5, J7.4, R21.2, U5.5 (GPIO5/TOUCH5/ADC1_CH4)
SDA: J3.3, J7.3, R20.2, U5.4 (GPIO4/TOUCH4/ADC1_CH3)
VBUS: C23.1, C25.1, D1.2 (A), J1.A9 (VBUS), J1.B9 (VBUS), J2.1, R10.2, R12.2, R13.1, U4.4 (VCC)
XMCLK: J3.13, U5.8 (GPIO15/U0RTS/ADC2_CH4/XTAL_32K_P)

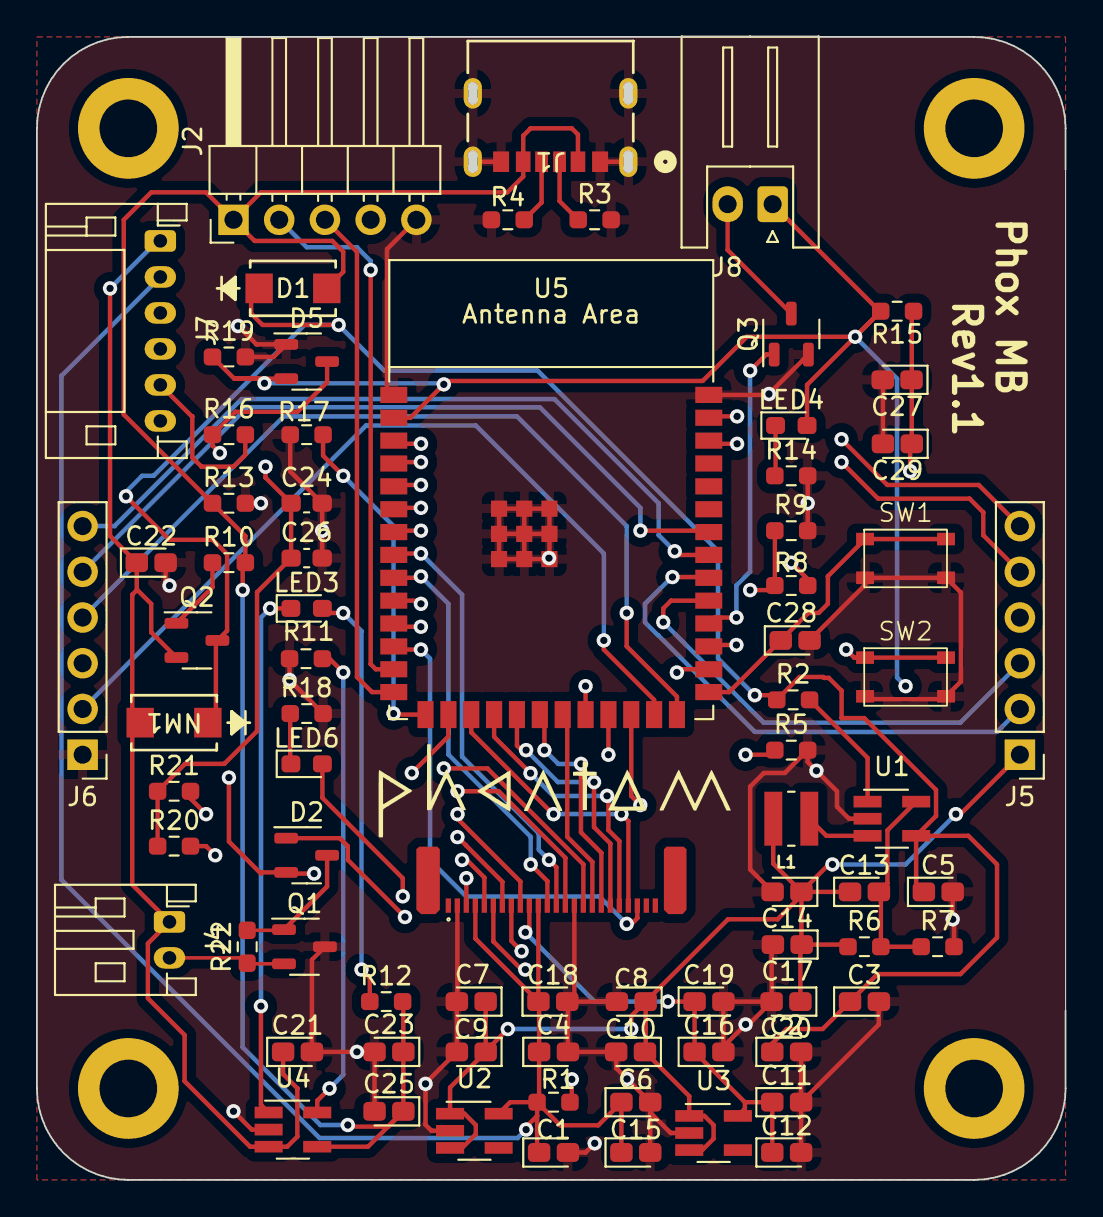
[picture p22: board main-board.kicad_pcb from above]

Board: 4 copper layers, 57.2 x 63.5 mm, 77 parts (0 on the bottom side), 58 nets.
