team-phantom-community/Phox_Hardware/KiCad/hall-laser-unit-Rev2.0/hall-laaser-unit/hall-laaser-unit.kicad_pcb

## KiCad design KiCad/hall-laser-unit-Rev2.0/hall-laaser-unit/hall-laaser-unit.kicad_pcb (2024-04-12)

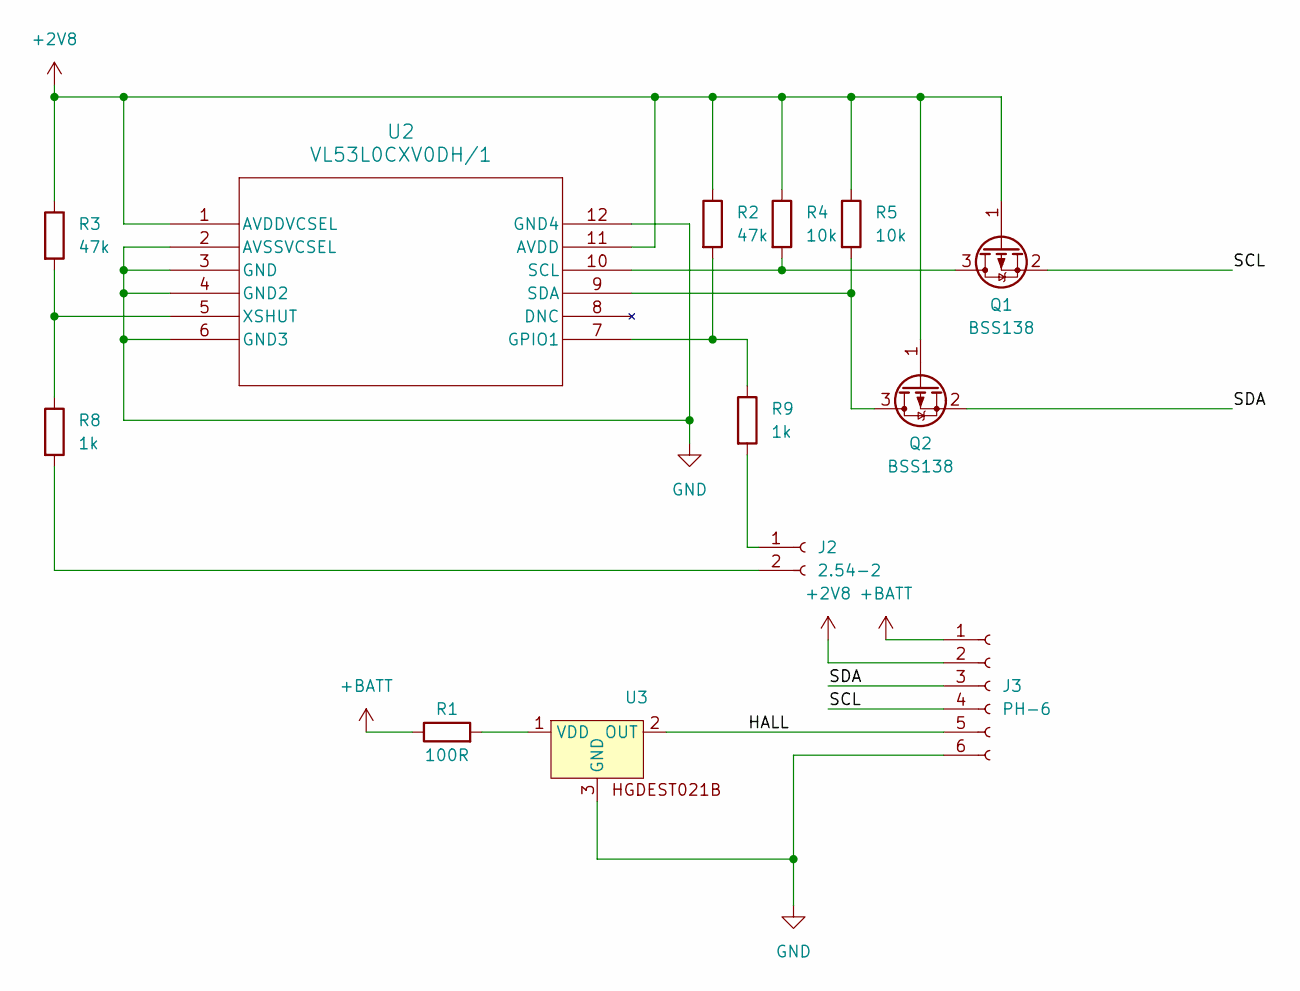
[picture p23: schematic hall-laaser-unit.kicad_sch]

Parts:
J2: 2.54-2; PinHeader_1x02_P2.54mm_Vertical
J3: PH-6; JST_PH_S6B-PH-K_1x06_P2.00mm_Horizontal
Q1, Q2: BSS138; SOT-23-3
R1: 100R; R_0603_1608Metric_Pad0.98x0.95mm_HandSolder
R2, R3: 47k; R_0603_1608Metric_Pad0.98x0.95mm_HandSolder
R4, R5: 10k; R_0603_1608Metric_Pad0.98x0.95mm_HandSolder
R8, R9: 1k; R_0603_1608Metric_Pad0.98x0.95mm_HandSolder
U2: VL53L0CXV0DH/1; LGA12_STM-M
U3: SOT-23-3

Connections:
+2V8: J3.2, Q1.1 (G), Q2.1 (G), R2.1, R3.1, R4.1, R5.1, U2.1 (AVDDVCSEL), U2.11 (AVDD)
+BATT: J3.1, R1.1
/HALL: J3.5, U3.2 (OUT)
/SCL: J3.4, Q1.2 (S)
/SDA: J3.3, Q2.2 (S)
GND: J3.6, U2.2 (AVSSVCSEL), U2.3 (GND), U2.4 (GND2), U2.6 (GND3), U2.12 (GND4), U3.3 (GND)
unnamed: J2.1, R9.2
unnamed: J2.2, R8.2
unnamed: Q1.3 (D), R4.2, U2.10 (SCL)
unnamed: Q2.3 (D), R5.2, U2.9 (SDA)
unnamed: R2.2, R9.1, U2.7 (GPIO1)
unnamed: R3.2, R8.1, U2.5 (XSHUT)
unnamed: R1.2, U3.1 (VDD)

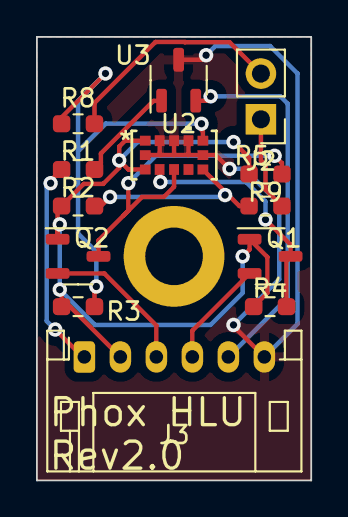
[picture p24: board hall-laaser-unit.kicad_pcb from above]

Board: 2 copper layers, 15.2 x 24.6 mm, 13 parts (0 on the bottom side), 13 nets.
