team-phantom-community/Phox_Hardware/(commit log)

2024-04-11 add kicad files
    [LED-Unit.kicad_pcb, LED-Unit.kicad_sch, hall-laaser-unit.kicad_pcb, hall-laaser-unit.kicad_sch, main-board.kicad_pcb, main-board.kicad_sch]
2024-04-12 update kicad readme
    [partitions.csv]
2024-04-12 create phox code info
    [3D_MA-base.stl, 3D_MA-cam-top.stl, 3D_MA_LED-cover.stl, 3D_MA_LED-top.stl, 3D_MG_magnet-unit.stl, 3D_SA_base.stl, 3D_SA_top.stl, Laser-Hall-Unit.stl]
